ssalin/Practicum/README.md

# Practicum

adding the following libraries for eagle:

https://github.com/sparkfun/SparkFun-Eagle-Libraries
https://github.com/adafruit/Adafruit-Eagle-Library
