ssalin/Practicum/Documentation/Project Planning/BluDAQ Project Schedule (V1.0).png

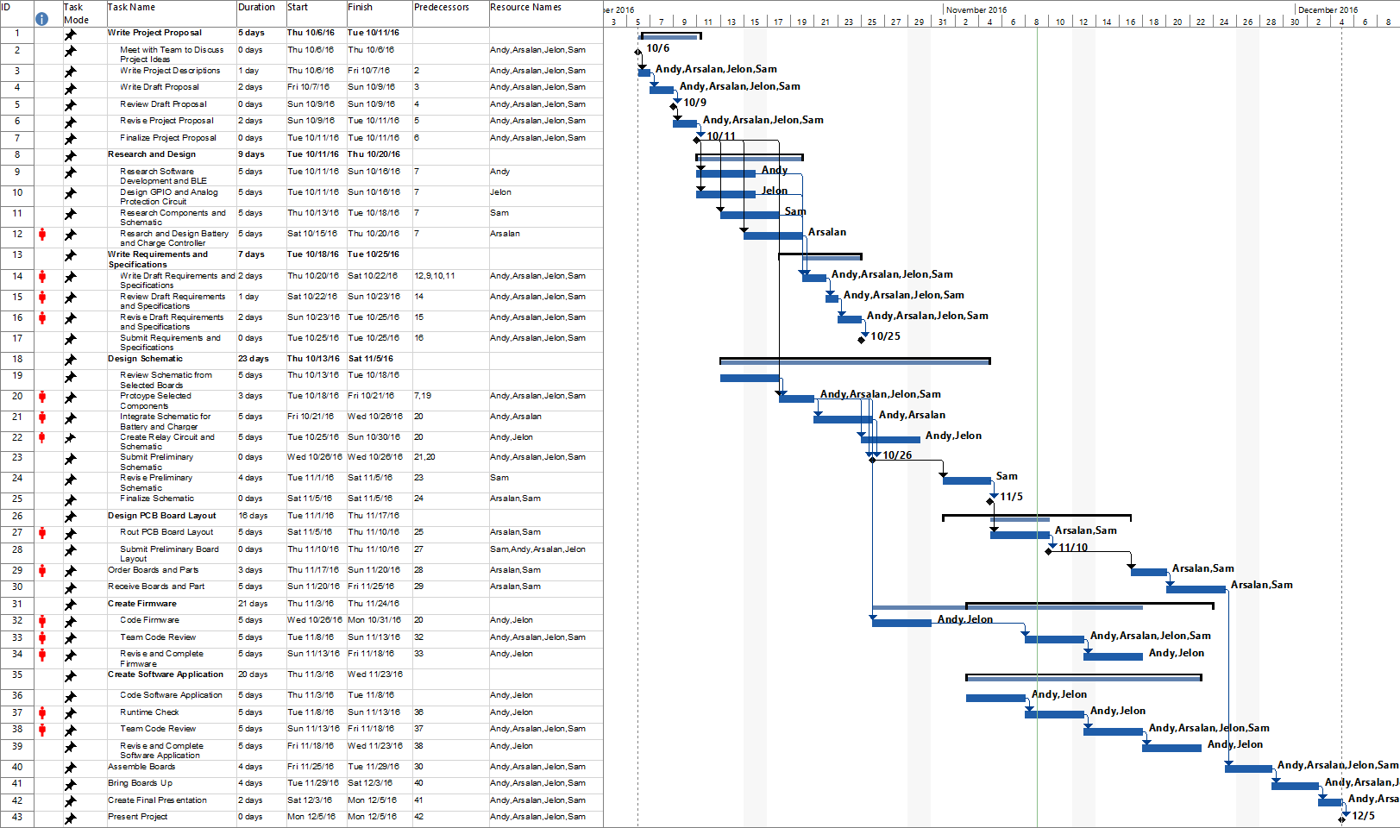
Documentation/Project Planning/BluDAQ Project Schedule (V1.0).png
