ssalin/Practicum/Hardware/refrence_schematics/ATMega8 Schm.jpg

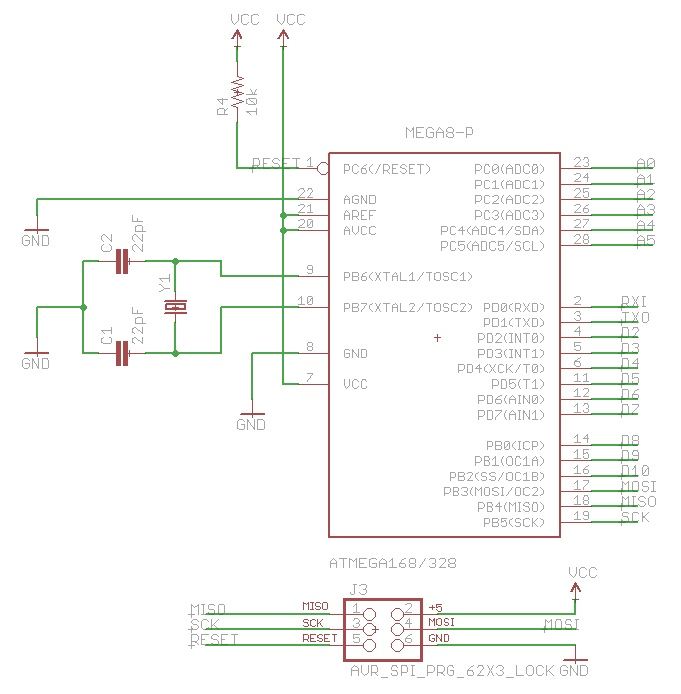
Hardware/refrence_schematics/ATMega8 Schm.jpg
