ssalin/Practicum/Hardware/schematics/Layout Proposal.png

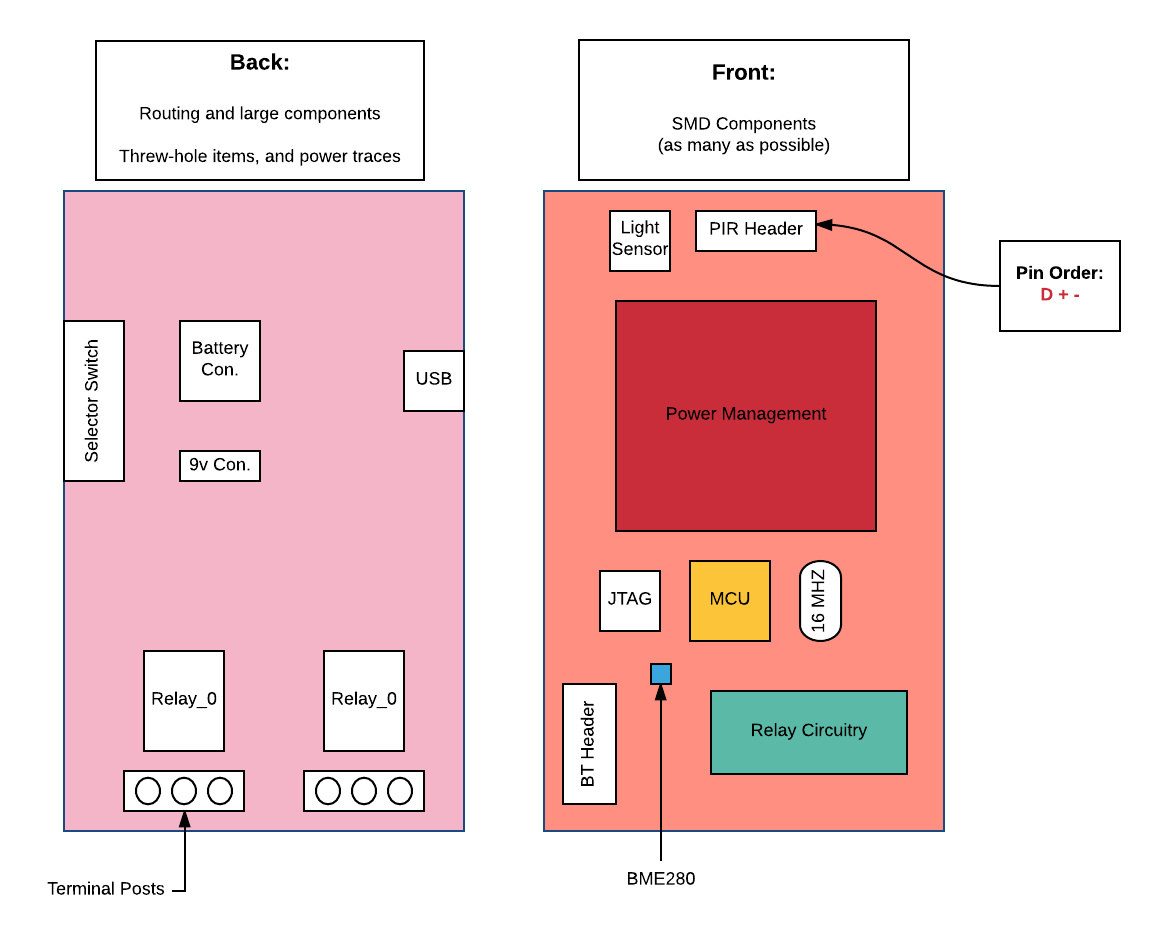
Hardware/schematics/Layout Proposal.png
