ssalin/Practicum/Hardware/schematics/layout_Nov_16.png

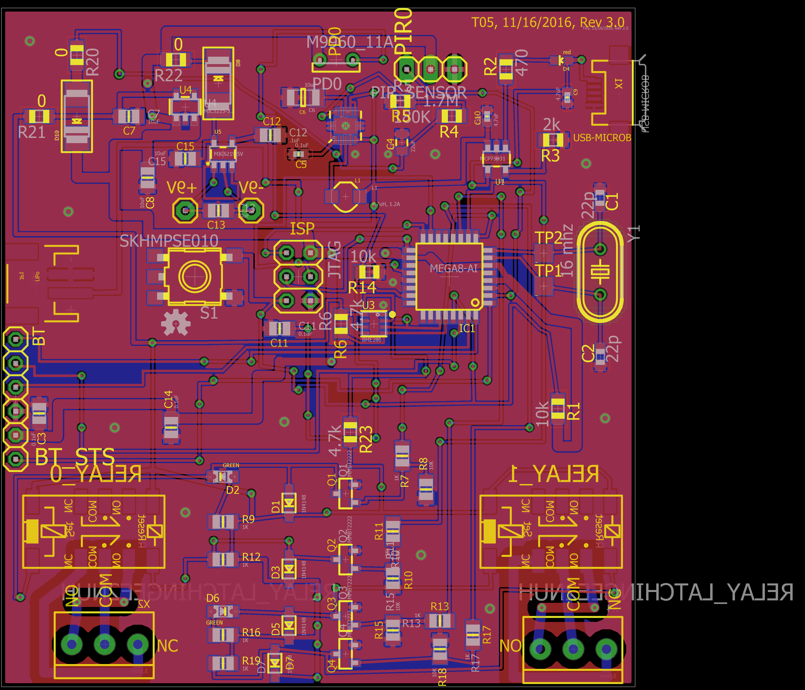
Hardware/schematics/layout_Nov_16.png
