ssalin/Practicum/Hardware/schematics/schematic_Nov_16.png

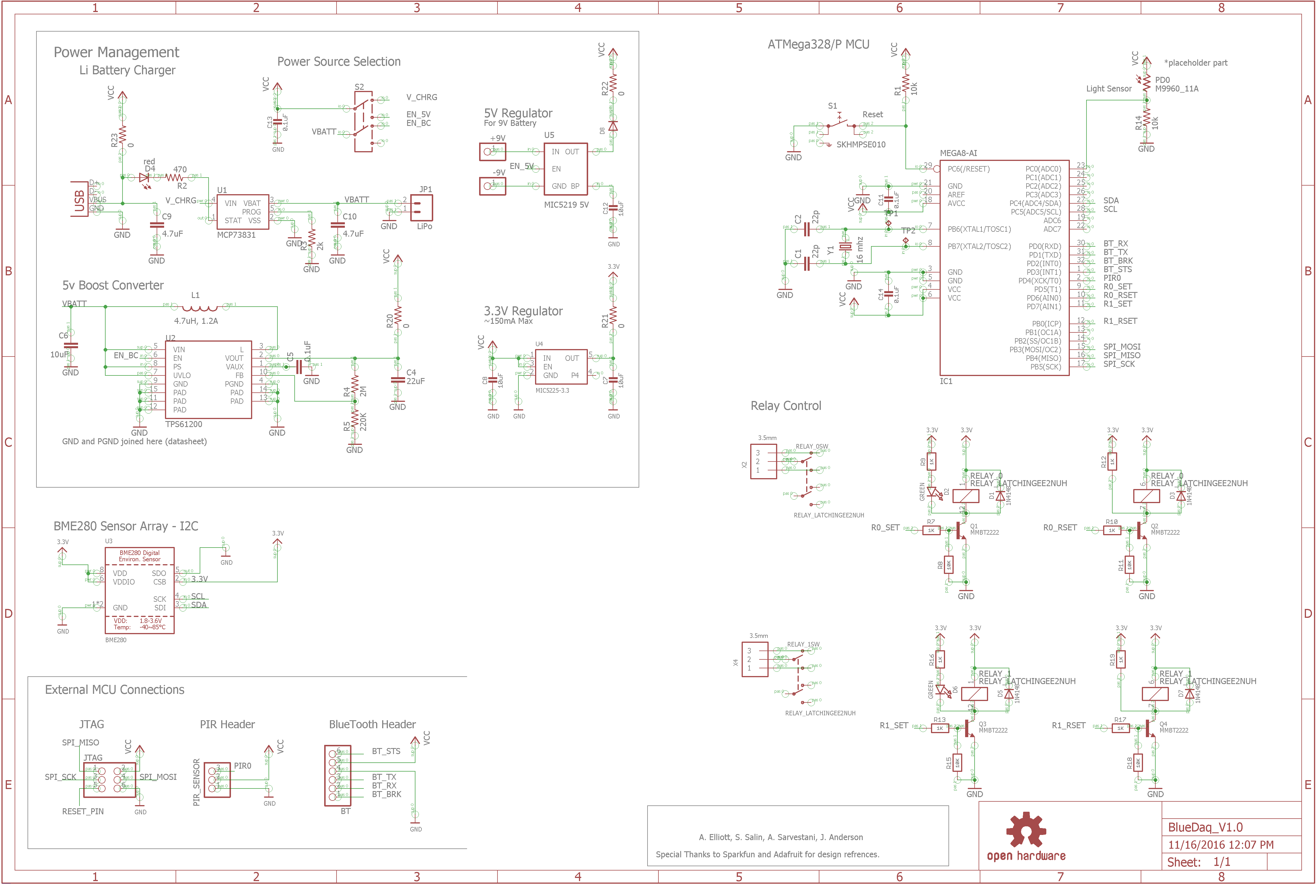
Hardware/schematics/schematic_Nov_16.png
