ssalin/Practicum/Hardware/Docs/Parts_list.xlsx

Part | Value | Numer Needed Per board | Package | Price Per Unit | Cost per board | # boards | Total Cost
PIR sensor |  | 1 |  | 9.95 | 9.95 |  | 39.8
Bluetooth Adaptor |  | 1 |  |  | 0 |  | 0
Capactior | 22p | 2 | C0805 | 0.1 | 0.2 |  | 0.8
Capactior | 0.1uF | 5 | 0805-NO@1 | 0.1 | 0.5 |  | 2
Capactior | 22uF | 1 | 805 | 0.23 | 0.23 |  | 0.92
Capactior | 10uF | 1 | 1206 | 0.22 | 0.22 |  | 0.88
Capactior | 10uF | 4 | 805 | 0.13 | 0.52 |  | 2.08
Capactior | 4.7uF | 2 | 805 | 0.15 | 0.3 |  | 1.2
Resistor | 10k | 6 | R0805 | 0.1 | 0.6 |  | 2.4
Resistor | 470 | 1 | R0805 | 0.1 | 0.1 |  | 0.4
Resistor | 2k | 1 | R0805 | 0.1 | 0.1 |  | 0.4
Resistor | 1.7M | 1 | R0805 | 0.1 | 0.1 |  | 0.4
Resistor | 180k | 1 | R0805 | 0.1 | 0.1 |  | 0.4
Resistor | 4.7k | 2 | R0805 | 0.1 | 0.2 |  | 0.8
Resistor | 1k | 8 | R0805 | 0.1 | 0.8 |  | 3.2
Resistor | 0 | 3 | R0805 | 0.1 | 0.3 |  | 1.2
Diode | 1N4148 | 4 |  | 0.14 | 0.56 |  | 2.24
Diode | Green | 3 | 805 |  | 0 |  | 0
Diode |  | 2 | SMADIODE |  | 0 |  | 0
Processor | Atmega 328p | 1 | TQFP32-08 | 3.81 | 3.81 |  | 15.24
LiPo Connector |  | 1 | JST-2-SMD |  | 0 |  | 0
L1 4.7uH, 1.2A |  |  | CDRH2D09 |  | 0 |  | 0
PD0 | M9960_11A |  | M9960 |  | 0 |  | 0
NPN Transistor | MMBT2222 | 4 | SOT23-R | 0.1 | 0.4 |  | 1.6
RELAY | 2 |  |  |  | 0 |  | 0
S1 | SKHMPSE010 | 1 | SKHMPXE010 |  | 0 |  | 0
Test Pad |  | 2 | TP19SQ |  | 0 |  | 0
Battery Charger | MCP73831 | 1 | SOT23-5 | 0.56 | 0.56 |  | 2.24
Boost Converter | TPS61200 | 1 | QFN-10_PAD |  | 0 |  | 0
Temp/Humidity/Pressure sensor | BME280 | 1 | BME280 |  | 0 |  | 0
3.3v linear regulator | MIC5225-3.3 | 1 | SOT23-5 | 0.39 | 0.39 |  | 1.56
5v linear regulator | MIC5219 5V | 1 | SOT23-5 |  | 0 |  | 0
Micro USB adaptor | USB-MICROB | 1 | USB-MICROB | 0.46 | 0.46 |  | 1.84
X2 3.5mm | 2 | 2 | TERMBLOCK_1X3-3.5MM |  | 0 |  | 0
Y1 | 16 mhz | 1 | HC49U-V |  | 0 |  | 0
