ssalin/Practicum/Documentation/Team Docs/Practicum Cost Sheet.xlsx

Date | Purchase | Justification / Reason | Name of Purchaser | Retailer | Total Cost
2016-10-06 | Serial Bluetooth Device | Prototyping | Andy Elliott | PSU LID | $25.00
2016-10-06 | SPI BLE Devic, Environment Sensors, Photocell | Prototyping / Development | Andy Elliott | Adafruit | $48.05
2016-10-15 | 10x 5v SPST Relays | Prototype and Final | Andy Elliott | Amazon | $8.00
