ssalin/Practicum/Documentation/Project Planning/Idea Evaluation Matrix.xlsx

Idea | Est. Cost | Difficulty / Assembly | Astestics | Functionality | Practicality / Usefullness | Score
Automated Streetlight | 2 | 3 | 1 | 3.5 | 4 | 13.5
BLE DAS + FHT | 2 | 0 | 3 | 5 | 4 | 14
Programmable Game IF | 4 | 4 | 4 | 1 | 1 | 14
IR Blaster Remote | 4 | 3 | 3 | 2 | 3 | 15
Laser RC Car | 2 | 1 | 4 | 1 | 1 | 9
USB MIDI LED Driver | 3 | 3 | 1 | 2 | 2 | 11
EEG / EKG / EMG Control System |  |  |  |  |  | 0
Laser Shotgun | 0 | 0 | 4 | 0 | 0 | 4
