ssalin/Practicum/Firmware/BluDaq Firmware.pdf

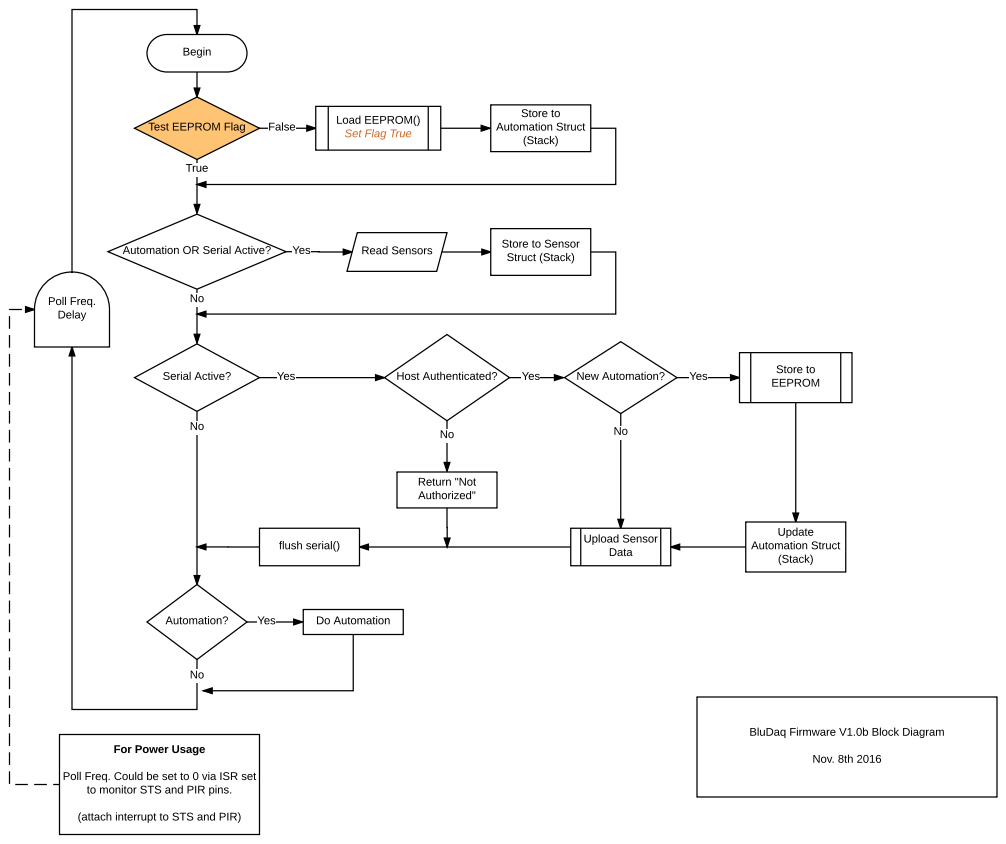
[picture p27: page 1]
Begin; Serial Active?; flush serial(); New Automation?; Nov. 8th 2016; Update Automation Struct (Stack); Automation?; Yes; Do Automation; Store to EEPROM; Read Sensors; False; True; Store to Automation Struct (Stack); Host Authenticated?; Return "Not Authorized"

Load EEPROM()
Set Flag True

Test EEPROM Flag

Automation OR Serial Active?

Store to Sensor
Struct (Stack)

Poll Freq. Delay

Upload Sensor Data

BluDaq Firmware V1.0b Block Diagram

For Power Usage

Poll Freq. Could be set to 0 via ISR set
to monitor STS and PIR pins.

(attach interrupt to STS and PIR)
