ssalin/Practicum/Hardware/Sim/411 Schematic.asc

D1: diode
M1: nmos
M2: nmos
R1: res; 1k
R2: res; 10k
R3: res; 10k
R4: res; 1k
R5: res; 1k
V1: voltage; 5
V2: voltage; PULSE(0 1 0.25 1m 1m 0.25 0.5 5)
V3: voltage; PULSE(0 3.3 0.50 1m 1m 0.50 1 5)
Named nets: 0
.tran 0 2.5 0
These inputs are GPIO signals. Before entering, it must go through two Opto Isolators
