ssalin/Practicum/Hardware/schematics/BlueDaq_V1.0.brd

## EAGLE design Hardware/schematics/BlueDaq_V1.0.brd (2016-11-17)

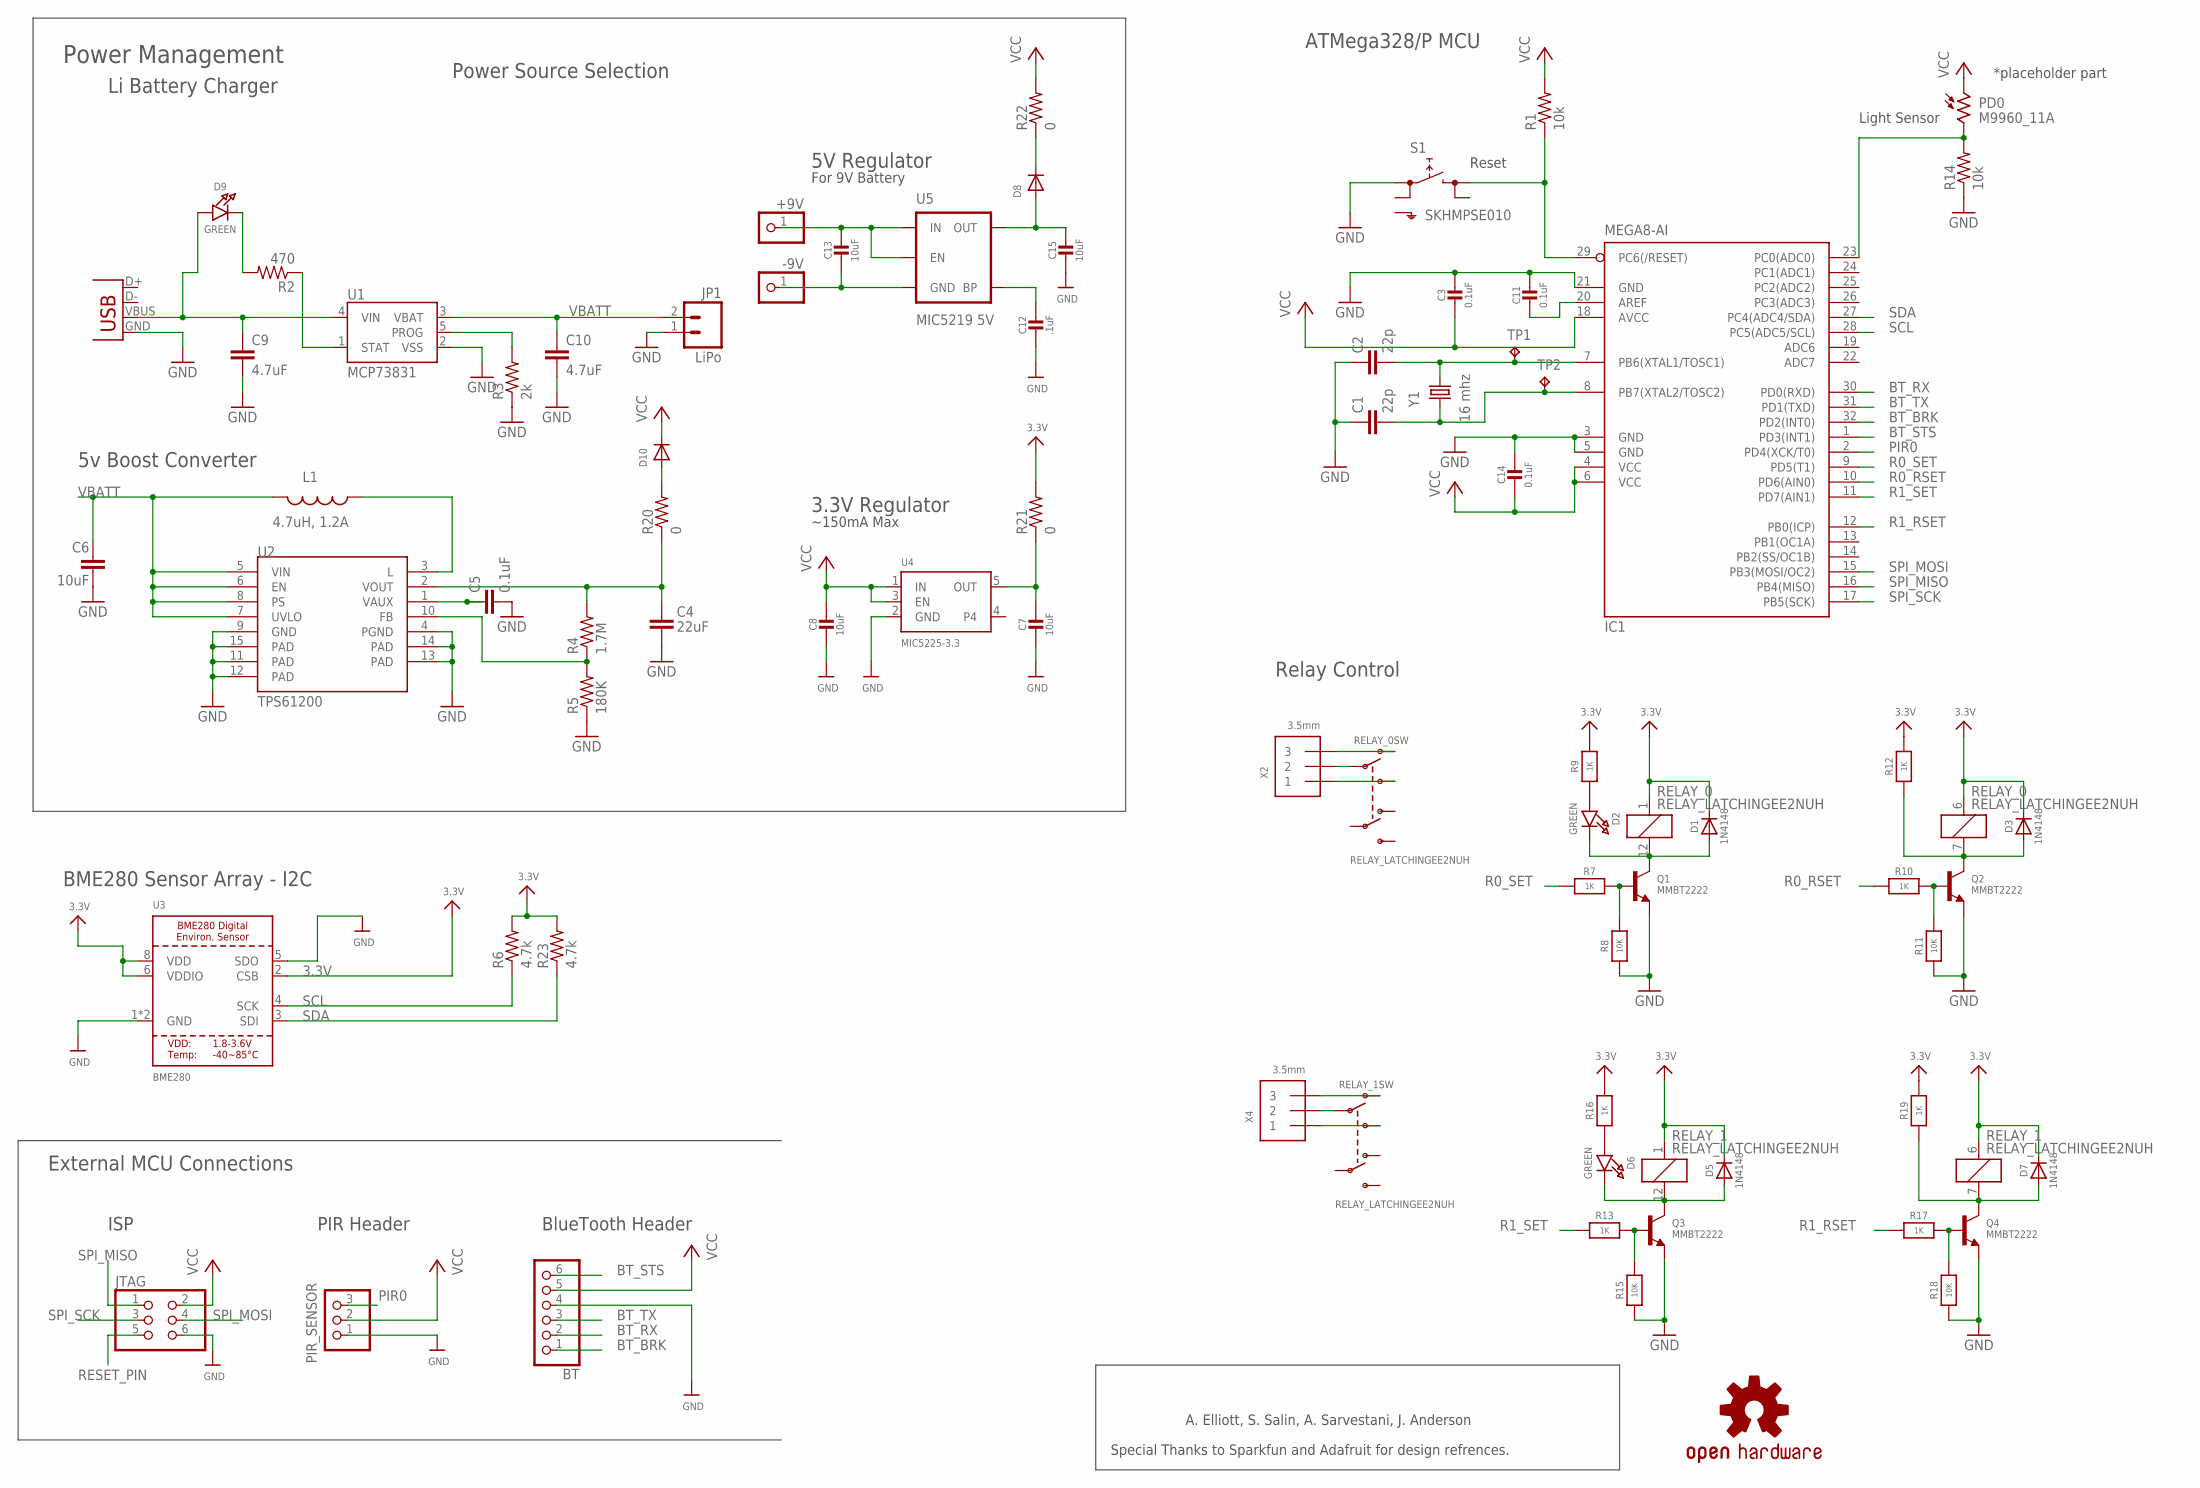
[picture p28: schematic BlueDaq_V1.0.sch]

Parts:
+9V: PINHD-1X1; 1X01
-9V: PINHD-1X1; 1X01
BT: PINHD-1X6; 1X06
C1, C2: 22p; C0805
C3, C11, C14: 0.1uF; 0805-NO@1
C4: 22uF; 0805
C5: 0.1uF; 0805
C6: 10uF; 1206
C7, C8, C13, C15: 10uF; 0805-NO@1
C9, C10: 4.7uF; 0805
C12: .1uF; 0805-NO@1
D1, D3, D5, D7: 1N4148; SOD-323
D2, D6, D9: GREEN; CHIPLED_0805_NOOUTLINE
D8, D10: DIODESMA; SMADIODE
IC1: MEGA8-AI; TQFP32-08
JP1: LiPo; JST-2-SMD
JTAG: PINHD-2X3; 2X03
L1: 4.7uH, 1.2A; CDRH2D09
PD0: M9960_11A; M9960
PIR_SENSOR: PINHD-1X3; 1X03
Q1, Q2, Q3, Q4: MMBT2222; SOT23-R
R1, R14: 10k; R0805
R2: 470; R0805
R3: 2k; R0805
R4: 1.7M; R0805
R5: 180K; R0805
R6, R23: 4.7k; R0805
R7, R9, R10, R12, R13, R16, R17, R19: 1K; 0805-NO
R8, R11, R15, R18: 10K; 0805-NO
R20, R21, R22: 0; R0805
RELAY_0, RELAY_1: RELAY_LATCHINGEE2NUH; RELAY_EE2_LATCH
S1: SKHMPSE010; SKHMPXE010
TP1, TP2: TPTP19SQ; TP19SQ
U1: MCP73831; SOT23-5
U2: TPS61200; QFN-10_PAD
U3: BME280
U4: MIC5225-3.3; SOT23-5
U5: MIC5219 5V; SOT23-5
U$22: OSHW-LOGOS; OSHW-LOGO-S
X1: USB-MICROB
X2, X4: 3.5mm; TERMBLOCK_1X3-3.5MM
Y1: 16 mhz; HC49U-V

Connections:
3.3V: D1.C, D3.C, D5.C, D7.C, R6.2, R9.2, R12.2, R16.2, R19.2, R21.2, R23.2, RELAY_0.1, RELAY_0.6 (1), RELAY_1.1, RELAY_1.6 (1), U3.2 (CSB), U3.6 (VDDIO), U3.8 (VDD)
BT_BRK: BT.1, IC1.32 (PD2(INT0))
BT_RX: BT.2, IC1.30 (PD0(RXD))
BT_STS: BT.6, IC1.1 (PD3(INT1))
BT_TX: BT.3, IC1.31 (PD1(TXD))
COM1: RELAY_0.9 (P1), X2.2
COM2: RELAY_1.9 (P1), X4.2
FB: R4.1, R5.2, U2.10 (FB)
GND: BT.4, C1.1, C2.1, C3.1, C4.2, C5.2, C6.2, C7.2, C8.2, C9.2, C10.2, C11.1, C12.2, C14.1, C15.2, IC1.3 (GND), IC1.5 (GND), IC1.21 (GND), JP1.1, JTAG.6, PIR_SENSOR.1, Q1.2 (E), Q2.2 (E), Q3.2 (E), Q4.2 (E), R3.1, R5.1, R8.1, R11.1, R14.1, R15.1, R18.1, S1.1 (1.1), U1.2 (VSS), U2.4 (PGND), U2.9 (GND), U2.11 (PAD), U2.12 (PAD), U2.13 (PAD), U2.14 (PAD), U2.15 (PAD), U3.1 (GND), U3.5 (SDO), U3.7 (GND), U4.2 (GND), X1.GND
unnamed: IC1.23 (PC0(ADC0)), PD0.2, R14.2
unnamed: L1.P$1 (1), U2.3 (L)
unnamed: C5.1, U2.1 (VAUX)
unnamed: D9.C, R2.2
unnamed: C15.1, D8.A, U5.5 (OUT)
unnamed: D1.A, D2.C, Q1.3 (C), RELAY_0.12 (2)
unnamed: D5.A, D6.C, Q3.3 (C), RELAY_1.12 (2)
unnamed: Q3.1 (B), R13.2, R15.2
unnamed: D6.A, R16.1
unnamed: RELAY_1.10 (O1), X4.3
unnamed: R3.2, U1.5 (PROG)
unnamed: D7.A, Q4.3 (C), R19.1, RELAY_1.7 (2)
unnamed: Q4.1 (B), R17.2, R18.2
unnamed: R2.1, U1.1 (STAT)
unnamed: +9V.1, C13.1, U5.1 (IN), U5.3 (EN)
unnamed: -9V.1, C13.2, U5.2 (GND)
unnamed: C12.1, U5.4 (BP)
unnamed: D8.C, R22.1
unnamed: D10.A, R20.2
unnamed: Q1.1 (B), R7.2, R8.2
unnamed: C9.1, D9.A, U1.4 (VIN), X1.VBUS
unnamed: D3.A, Q2.3 (C), R12.1, RELAY_0.7 (2)
unnamed: D2.A, R9.1
unnamed: Q2.1 (B), R10.2, R11.2
unnamed: RELAY_0.10 (O1), X2.3
unnamed: C11.2, IC1.20 (AREF)
NO1: RELAY_0.8 (S1), X2.1
NO2: RELAY_1.8 (S1), X4.1
OUT: C7.1, R21.1, U4.5 (OUT)
PIR0: IC1.2 (PD4(XCK/T0)), PIR_SENSOR.3
R0_RSET: IC1.10 (PD6(AIN0)), R10.1
R0_SET: IC1.9 (PD5(T1)), R7.1
R1_RSET: IC1.12 (PB0(ICP)), R17.1
R1_SET: IC1.11 (PD7(AIN1)), R13.1
RESET_PIN: IC1.29 (PC6(/RESET)), JTAG.5, R1.1, S1.3 (2.1)
SCL: IC1.28 (PC5(ADC5/SCL)), R6.1, U3.4 (SCK)
SDA: IC1.27 (PC4(ADC4/SDA)), R23.1, U3.3 (SDI)
SPI_MISO: IC1.16 (PB4(MISO)), JTAG.1
SPI_MOSI: IC1.15 (PB3(MOSI/OC2)), JTAG.4
SPI_SCK: IC1.17 (PB5(SCK)), JTAG.3
VBATT: C6.1, C10.1, JP1.2, L1.P$2 (2), U1.3 (VBAT), U2.5 (VIN), U2.6 (EN), U2.7 (UVLO), U2.8 (PS)
VCC: BT.5, C3.2, C8.1, C14.2, D10.C, IC1.4 (VCC), IC1.6 (VCC), IC1.18 (AVCC), JTAG.2, PD0.1, PIR_SENSOR.2, R1.2, R22.2, U4.1 (IN), U4.3 (EN)
VOUT: C4.1, R4.2, R20.1, U2.2 (VOUT)
XTAL1: C2.2, IC1.7 (PB6(XTAL1/TOSC1)), TP1.TP, Y1.2
XTAL2: C1.2, IC1.8 (PB7(XTAL2/TOSC2)), TP2.TP, Y1.1

Notes on the sheet:
Li Battery Charger
5v Boost Converter
ATMega328/P MCU
Reset
External MCU Connections
BME280 Sensor Array - I2C
~150mA Max
3.3V Regulator
ISP
PIR Header
BlueTooth Header
Light Sensor
*placeholder part
Relay Control
5V Regulator
For 9V Battery
Power Source Selection
Power Management
A. Elliott, S. Salin, A. Sarvestani, J. Anderson
Special Thanks to Sparkfun and Adafruit for design refrences.

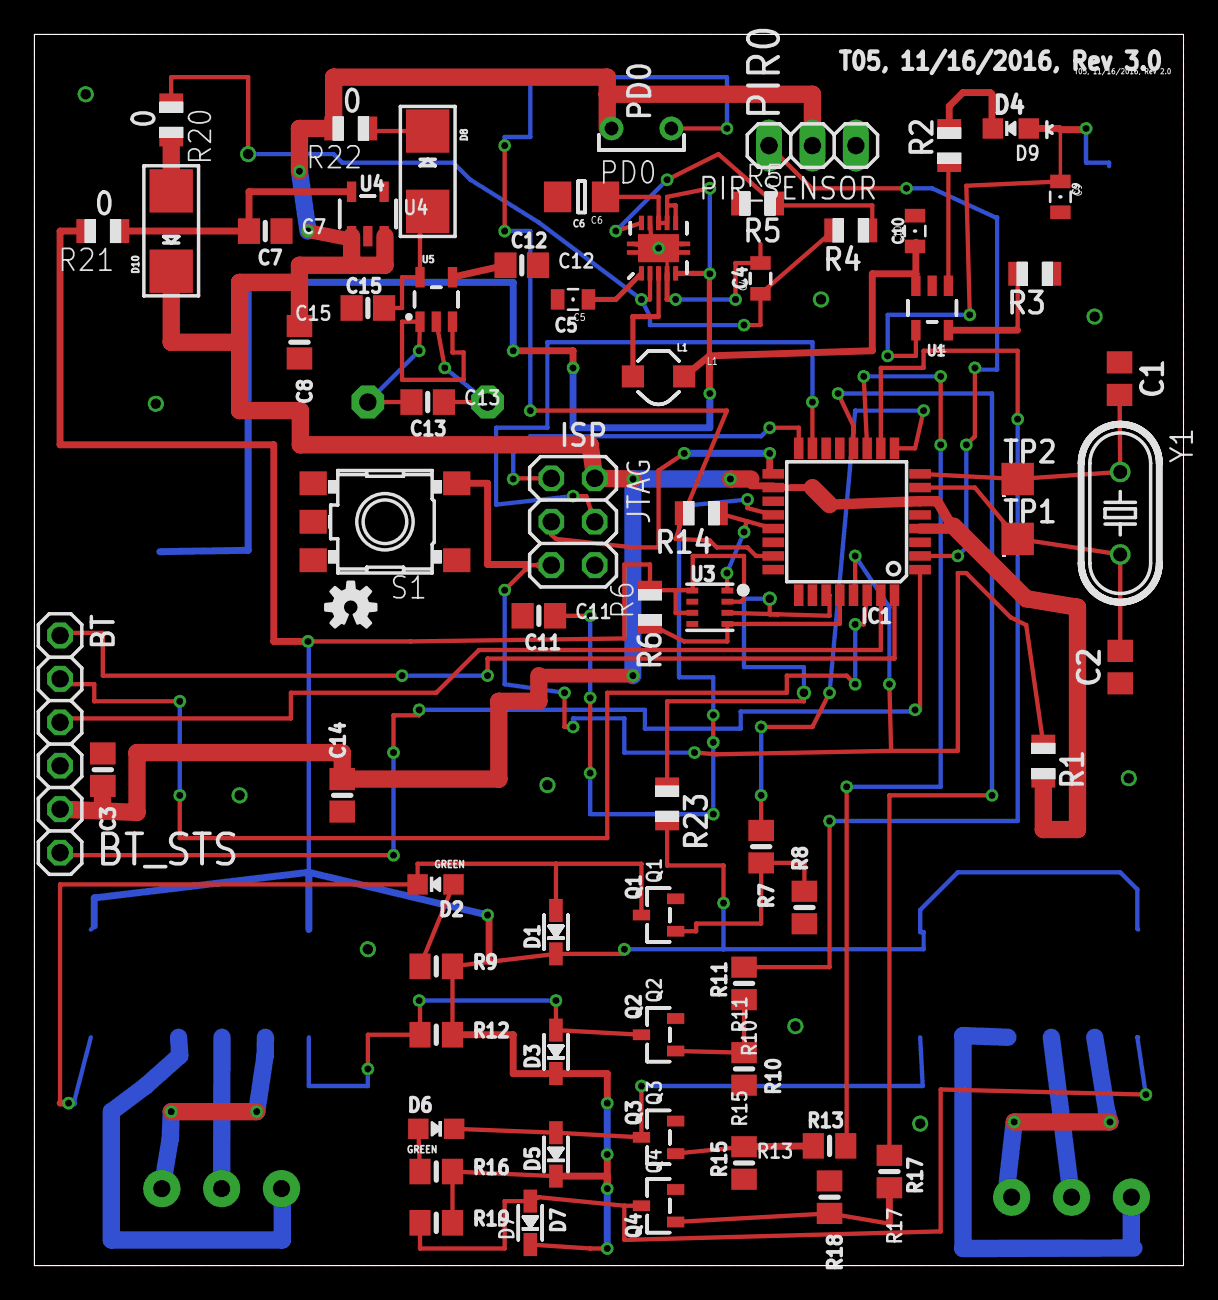
[picture p29: board BlueDaq_V1.0.brd from above]

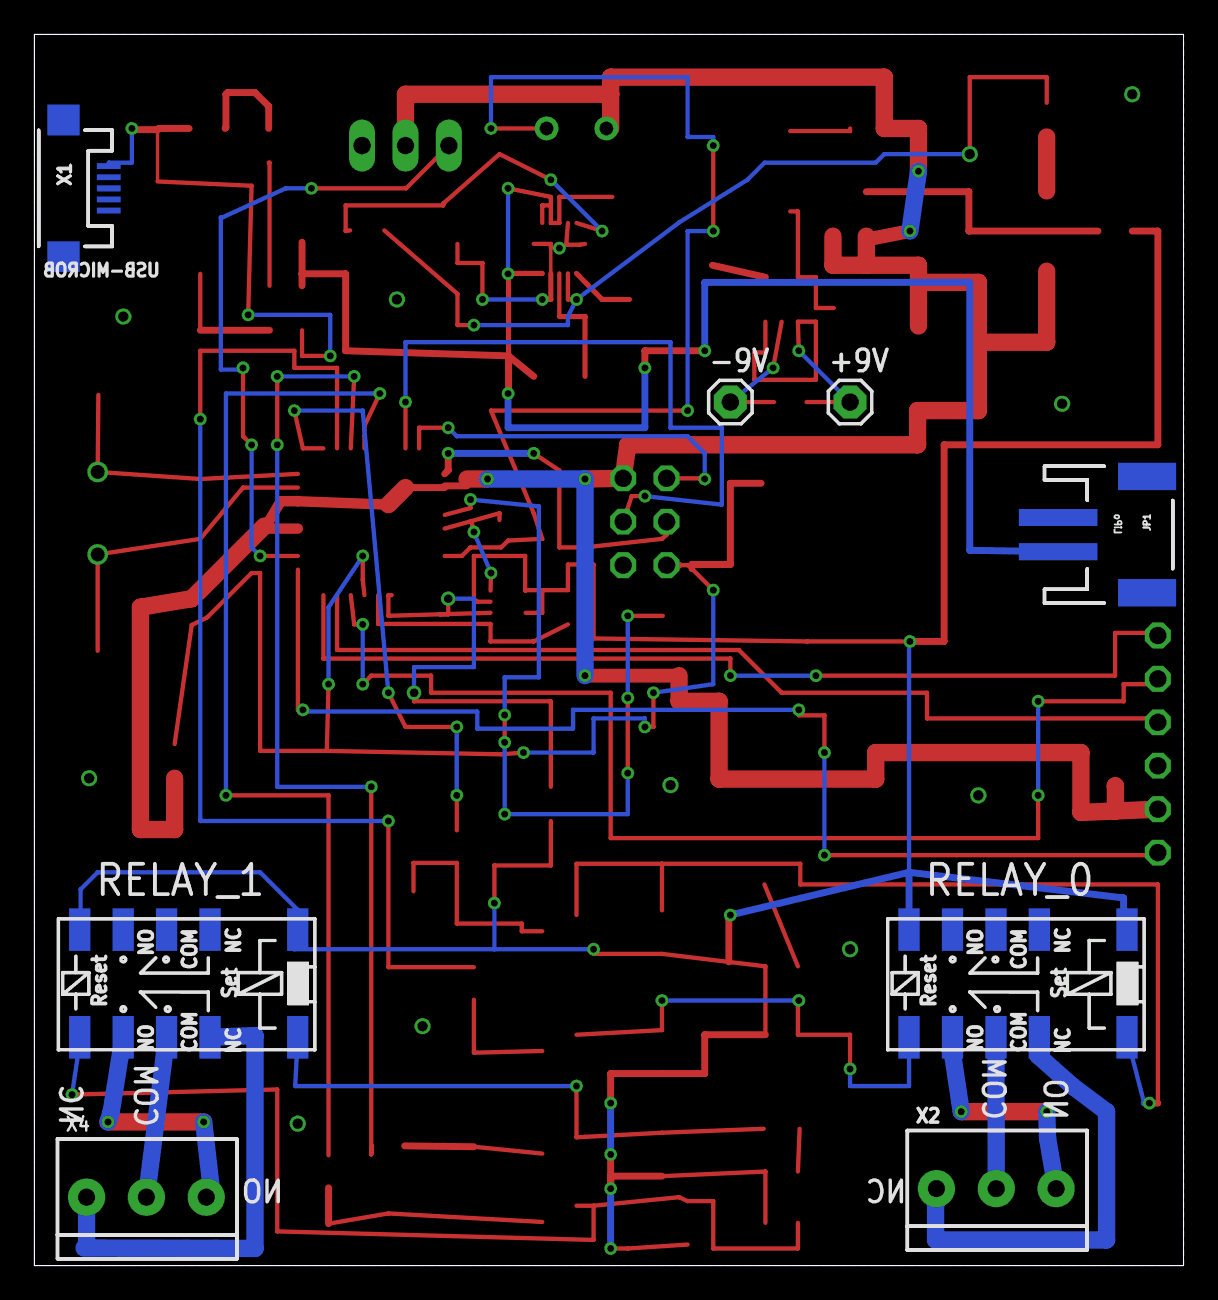
[picture p30: board BlueDaq_V1.0.brd from below]

Board: 2 copper layers, 67.2 x 72.0 mm, 75 parts (8 on the bottom side), 54 nets.
