ssalin/Practicum/Hardware/refrence_schematics/adafruit/Adafruit Relay FeatherWing.brd

## EAGLE design Hardware/refrence_schematics/adafruit/Adafruit Relay FeatherWing.brd (2016-11-03)

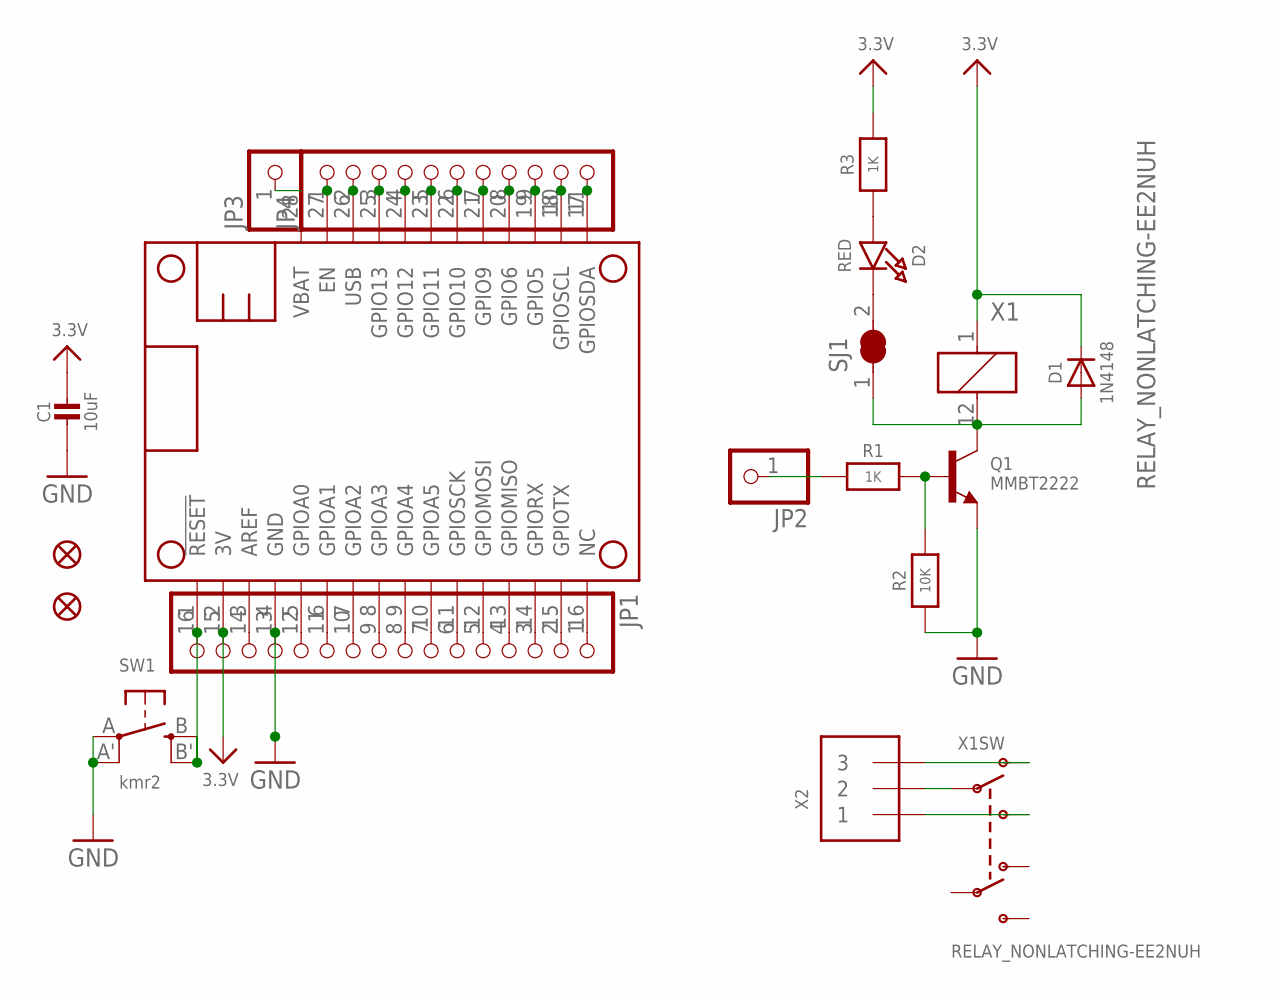
[picture p31: schematic Adafruit Relay FeatherWing.sch]

Parts:
C1: 10uF; 0805-NO
D1: 1N4148; SOD-323
D2: RED; CHIPLED_0805_NOOUTLINE
FID2, FID3: FIDUCIAL""; FIDUCIAL_1MM
JP1: HEADER-1X16ROUND; 1X16_ROUND
JP2, JP3: HEADER-1X1ROUND; 1X01_ROUND
JP4: HEADER-1X11; 1X11_ROUND
MS1: MICROSHIELD
Q1: MMBT2222; SOT23-R
R1, R3: 1K; 0805-NO
R2: 10K; 0805-NO
SJ1: SOLDERJUMPER_CLOSED; SOLDERJUMPER_CLOSEDWIRE
SW1: kmr2; BTN_KMR2_4.6X2.8
X1: RELAY_NONLATCHING-EE2NUH; RELAY_EE2_NOLATCH
X2: TERMBLOCK_1X3; TERMBLOCK_1X3-3.5MM

Connections:
3.3V: C1.1, D1.C, JP1.15, MS1.2 (3V), R3.2, X1.1
COM1: X1.9 (P1), X2.2
GND: C1.2, JP1.13, MS1.4 (GND), Q1.2 (E), R2.1, SW1.A, SW1.A' (P1)
unnamed: D1.A, Q1.3 (C), SJ1.1, X1.12 (2)
unnamed: JP1.1, MS1.16 (NC)
unnamed: JP1.2, MS1.15 (GPIOTX)
unnamed: JP1.3, MS1.14 (GPIORX)
unnamed: JP1.4, MS1.13 (GPIOMISO)
unnamed: JP1.5, MS1.12 (GPIOMOSI)
unnamed: JP1.6, MS1.11 (GPIOSCK)
unnamed: JP1.7, MS1.10 (GPIOA5)
unnamed: JP1.8, MS1.9 (GPIOA4)
unnamed: JP1.9, MS1.8 (GPIOA3)
unnamed: JP1.10, MS1.7 (GPIOA2)
unnamed: JP1.11, MS1.6 (GPIOA1)
unnamed: JP1.12, MS1.5 (GPIOA0)
unnamed: JP4.1, MS1.27 (EN)
unnamed: JP4.3, MS1.25 (GPIO13)
unnamed: JP4.4, MS1.24 (GPIO12)
unnamed: JP4.5, MS1.23 (GPIO11)
unnamed: JP4.6, MS1.22 (GPIO10)
unnamed: JP4.7, MS1.21 (GPIO9)
unnamed: JP4.8, MS1.20 (GPIO6)
unnamed: JP4.9, MS1.19 (GPIO5)
unnamed: Q1.1 (B), R1.2, R2.2
unnamed: JP1.14, MS1.3 (AREF)
unnamed: JP2.1, R1.1
unnamed: D2.C, SJ1.2
unnamed: D2.A, R3.1
unnamed: X1.10 (O1), X2.3
NO1: X1.8 (S1), X2.1
RESET: JP1.16, MS1.1 (!RESET), SW1.B (S), SW1.B' (S1)
SCL: JP4.10, MS1.18 (GPIOSCL)
SDA: JP4.11, MS1.17 (GPIOSDA)
USB: JP4.2, MS1.26 (USB)
VBAT: JP3.1, MS1.28 (VBAT)

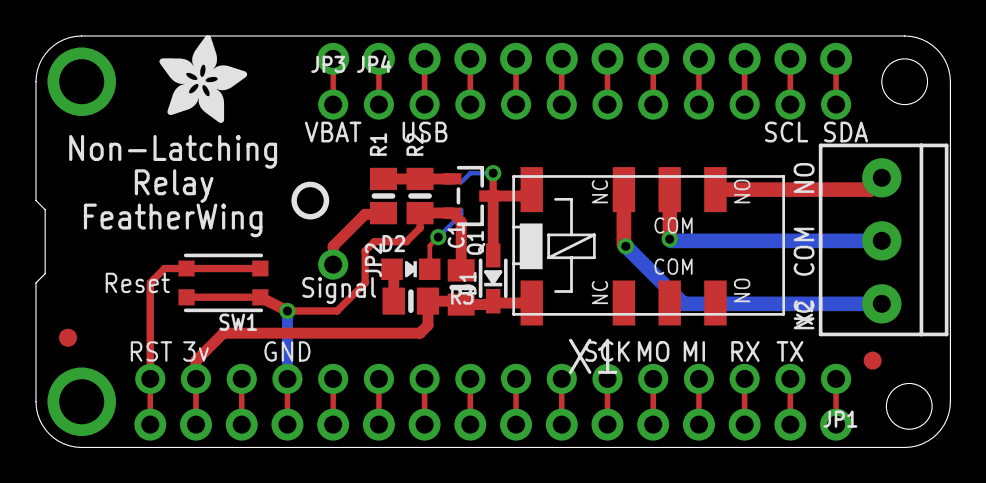
[picture p32: board Adafruit Relay FeatherWing.brd from above]

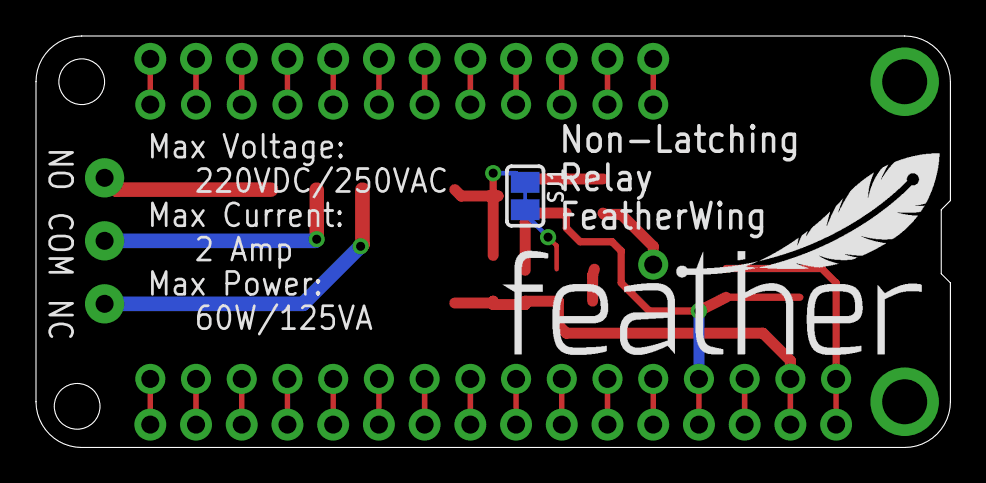
[picture p33: board Adafruit Relay FeatherWing.brd from below]

Board: 2 copper layers, 50.8 x 22.9 mm, 21 parts (2 on the bottom side), 36 nets.

Other parts of the board:
U$5: PCBFEAT-REV-040
U$6: FEATHERLOGO
U$7: ADAFRUIT_5MM
