ssalin/Practicum/Hardware/refrence_schematics/adafruit/Adafruit EZ-Link Breakout.brd

## EAGLE design Hardware/refrence_schematics/adafruit/Adafruit EZ-Link Breakout.brd (2016-11-03)

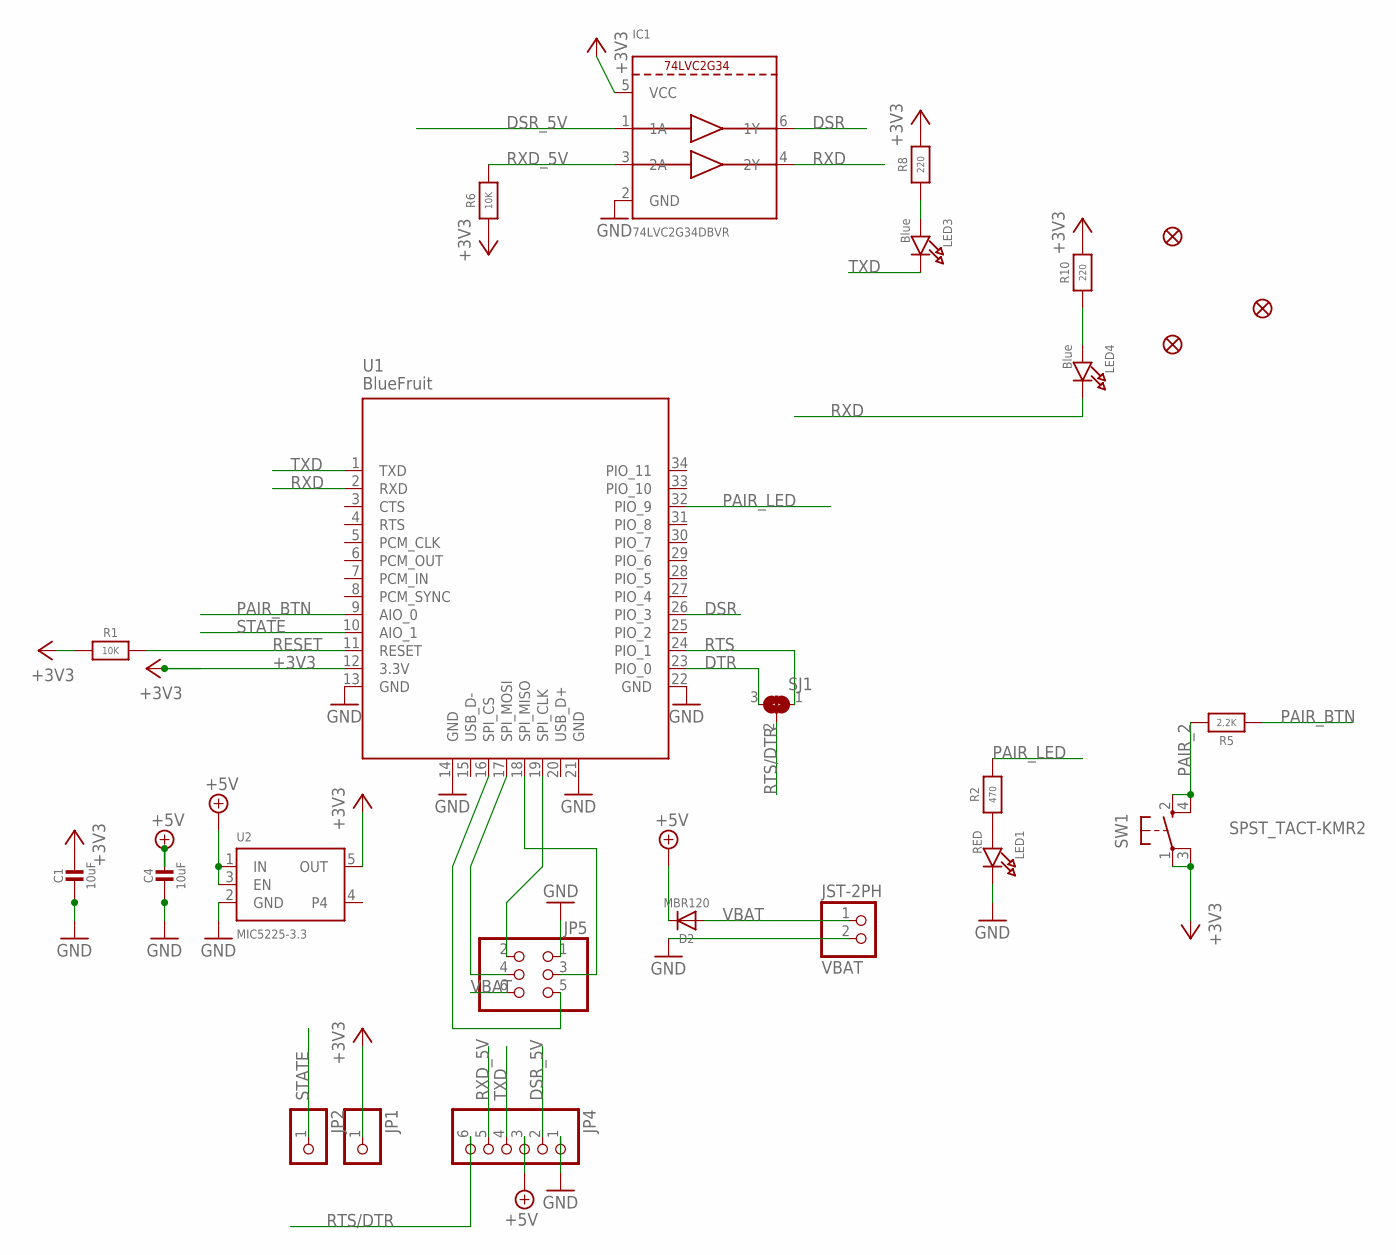
[picture p34: schematic Adafruit EZ-Link Breakout.sch]

Parts:
C1, C4: 10uF; 0805-NO
D2: MBR120; SOD-123
FID1, FID2, FID3: FIDUCIAL""; FIDUCIAL_1MM
IC1: 74LVC2G34DBVR; SOT23-6
JP1, JP2: PINHD-1X1CB; 1X01-CLEANBIG
JP4: PINHD-1X6B; 1X06-BIG
JP5: HEADER-2X3; 2X03_ROUND_70MIL
LED1: RED; CHIPLED_0805_NOOUTLINE
LED3, LED4: Blue; CHIPLED_0805_NOOUTLINE
R1: 10K; 0805-NO
R2: 470; 0805-NO
R5: 2.2K; 0805-NO
R6: 10K; _0805MP
R8, R10: 220; 0805-NO
SJ1: SOLDERJUMPER_2WAY; SOLDERJUMPER_2WAY_OPEN_NOPASTE
SW1: SPST_TACT-KMR2; KMR2
U1: BlueFruit; BLUETOOTH_MODULE
U2: MIC5225-3.3; SOT23-5
VBAT: JST-2PH; JST-PH-2-SMT-RA

Connections:
+3V3: C1.1, IC1.5 (VCC), JP1.1, R1.1, R6.1, R8.2, R10.2, SW1.1, SW1.3 (P1), U1.12 (3.3V), U2.5 (OUT)
+5V: C4.1, D2.C, JP4.3, U2.1 (IN), U2.3 (EN)
DSR: IC1.6 (1Y), U1.26 (PIO_3)
DSR_5V: IC1.1 (1A), JP4.2
DTR: SJ1.3, U1.23 (PIO_0)
GND: C1.2, C4.2, IC1.2 (GND), JP4.1, JP5.1, LED1.C, U1.13 (GND), U1.14 (GND), U1.21 (GND), U1.22 (GND), U2.2 (GND), VBAT.2 (1)
unnamed: LED1.A, R2.1
unnamed: LED3.A, R8.1
unnamed: LED4.A, R10.1
PAIR_2: R5.2, SW1.2 (S), SW1.4 (S1)
PAIR_BTN: R5.1, U1.9 (AIO_0)
PAIR_LED: R2.2, U1.32 (PIO_9)
RESET: R1.2, U1.11 (RESET)
RTS: SJ1.1, U1.24 (PIO_1)
RTS/DTR: JP4.6, SJ1.2
RXD: IC1.4 (2Y), LED4.C, U1.2 (RXD)
RXD_5V: IC1.3 (2A), JP4.5, R6.2
SPI_CLK: JP5.2, U1.19 (SPI_CLK)
SPI_CS: JP5.5, U1.16 (SPI_CS)
SPI_MISO: JP5.3, U1.18 (SPI_MISO)
SPI_MOSI: JP5.4, U1.17 (SPI_MOSI)
STATE: JP2.1, U1.10 (AIO_1)
TXD: JP4.4, LED3.C, U1.1 (TXD)
VBAT: D2.A, JP5.6, VBAT.1 (2)

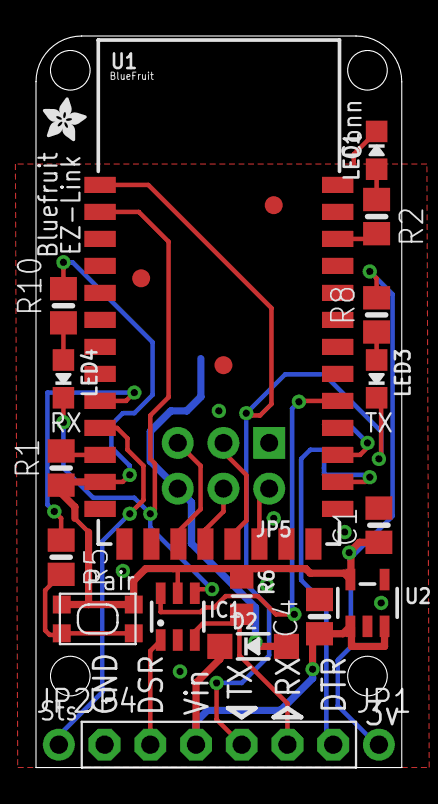
[picture p35: board Adafruit EZ-Link Breakout.brd from above]

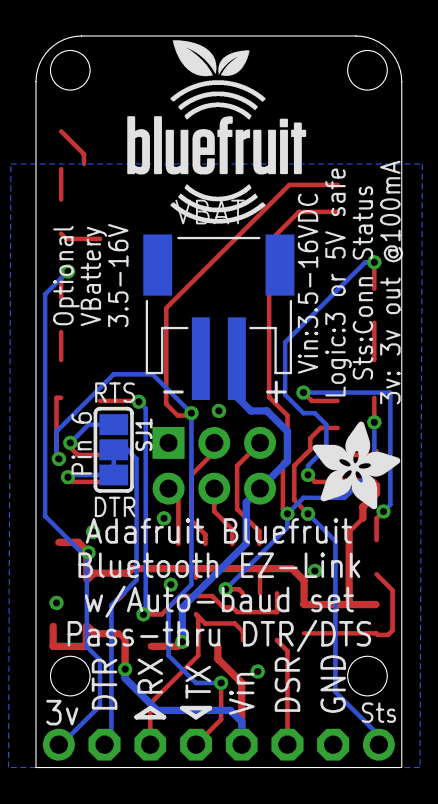
[picture p36: board Adafruit EZ-Link Breakout.brd from below]

Board: 2 copper layers, 20.3 x 40.6 mm, 28 parts (4 on the bottom side), 24 nets.

Other parts of the board:
U$2: ADAFRUIT_5MM
U$3: ADAFRUIT_2.5MM
U$4: BLUEFRUITLOGO_100MM
