ssalin/Practicum/Hardware/refrence_schematics/sparkfun/PowerCell-v13.brd

## EAGLE design Hardware/refrence_schematics/sparkfun/PowerCell-v13.brd (2016-11-03)

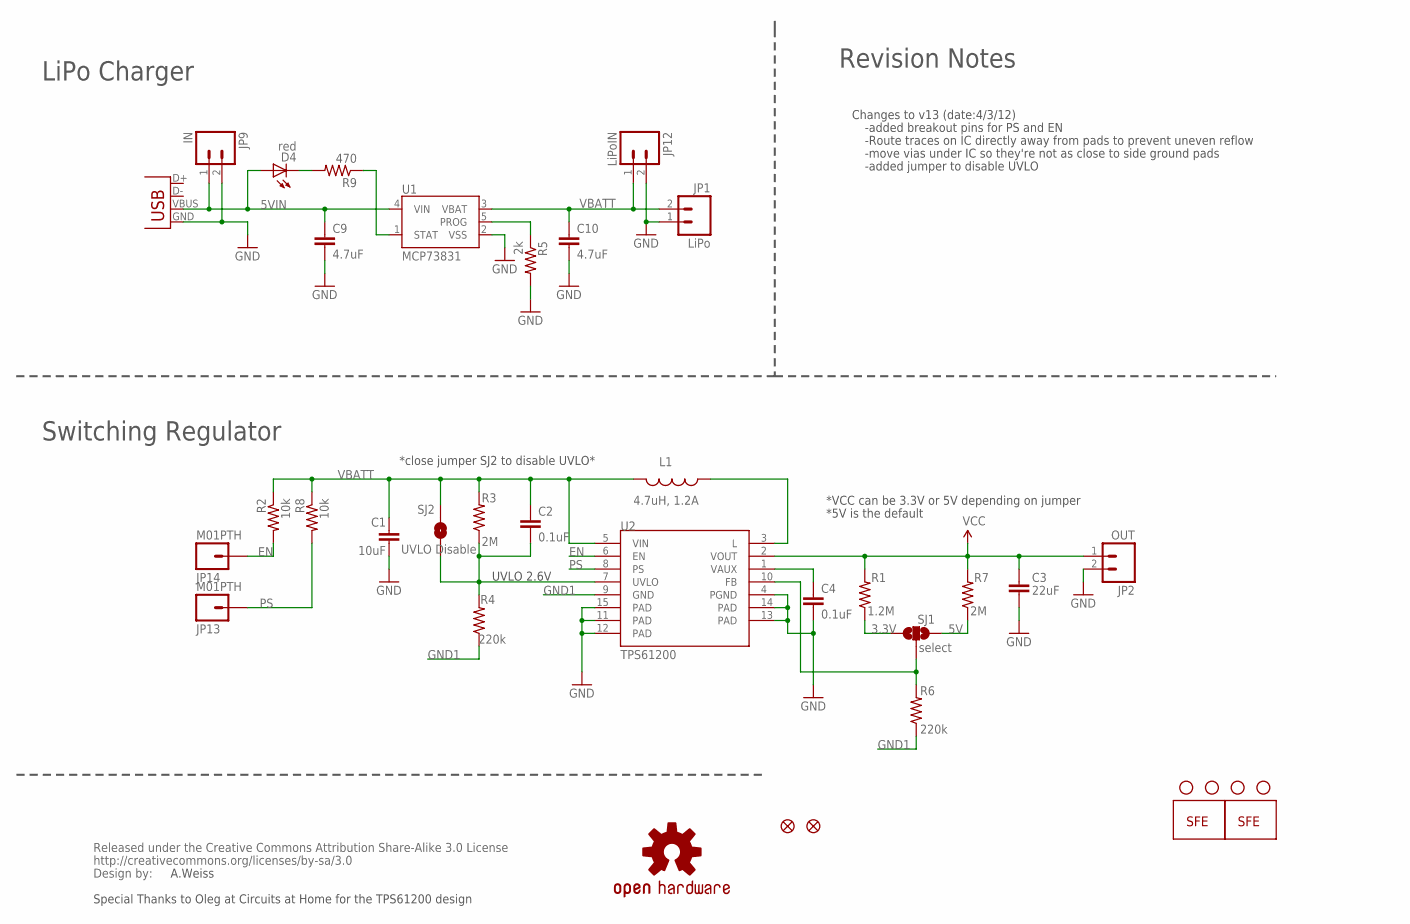
[picture p43: schematic PowerCell-v13.sch]

Parts:
C1: 10uF; 1206
C2, C4: 0.1uF; 0402-CAP
C3: 22uF; 0805
C9, C10: 4.7uF; 0402-CAP
D4: red; LED-0603
JP1: LiPo; JST-2-SMD
JP2: OUT; 1X02
JP3: LOGO-SFENEW; SFE-NEW-WEBLOGO
JP4: LOGO-SFESK; SFE-LOGO-FLAME
JP5, JP6, JP7, JP8: STAND-OFF
JP9: IN; 1X02
JP12: LiPoIN; 1X02
JP13, JP14: M01PTH; 1X01
JP15, JP16: FIDUCIALUFIDUCIAL; MICRO-FIDUCIAL
L1: 4.7uH, 1.2A; CDRH2D09
R1: 1.2M; 0402-RES
R2, R8: 10k; 0402-RES
R3, R7: 2M; 0402-RES
R4, R6: 220k; 0402-RES
R5: 2k; 0402-RES
R9: 470; 0402-RES
SJ1: select; SJ_3_PASTE2&3
SJ2: UVLO Disable; SJ_2S-NO
U1: MCP73831; SOT23-5
U2: TPS61200; QFN-10_PAD
U$1: OSHW-LOGOS; OSHW-LOGO-S
U$2: CREATIVE_COMMONS
X1: USB-MICROB

Connections:
3.3V: R1.1, SJ1.1
5V: R7.1, SJ1.3
5VIN: C9.1, D4.A, JP9.1, U1.4 (VIN), X1.VBUS
EN: JP14.1, R2.2, U2.6 (EN)
FB: R6.2, SJ1.2, U2.10 (FB)
GND: C1.2, C3.2, C4.2, C9.2, C10.2, JP1.1, JP2.2, JP9.2, JP12.2, R5.2, U1.2 (VSS), U2.4 (PGND), U2.11 (PAD), U2.12 (PAD), U2.13 (PAD), U2.14 (PAD), U2.15 (PAD), X1.GND
GND1: R4.1, R6.1, U2.9 (GND)
unnamed: C4.1, U2.1 (VAUX)
unnamed: L1.P$1 (1), U2.3 (L)
unnamed: D4.C, R9.2
unnamed: R5.1, U1.5 (PROG)
unnamed: R9.1, U1.1 (STAT)
PS: JP13.1, R8.2, U2.8 (PS)
UVLO: C2.2, R3.1, R4.2, SJ2.1, U2.7 (UVLO)
VBATT: C1.1, C2.1, C10.1, JP1.2, JP12.1, L1.P$2 (2), R2.1, R3.2, R8.1, SJ2.2, U1.3 (VBAT), U2.5 (VIN)
VCC: C3.1, JP2.1, R1.2, R7.2, U2.2 (VOUT)

Notes on the sheet:
UVLO 2.6V
Changes to v13 (date:4/3/12)
-added breakout pins for PS and EN
-Route traces on IC directly away from pads to prevent uneven reflow
-move vias under IC so they're not as close to side ground pads
*close jumper SJ2 to disable UVLO*
-added jumper to disable UVLO
A.Weiss
Special Thanks to Oleg at Circuits at Home for the TPS61200 design
LiPo Charger
Switching Regulator
Revision Notes
*VCC can be 3.3V or 5V depending on jumper
*5V is the default

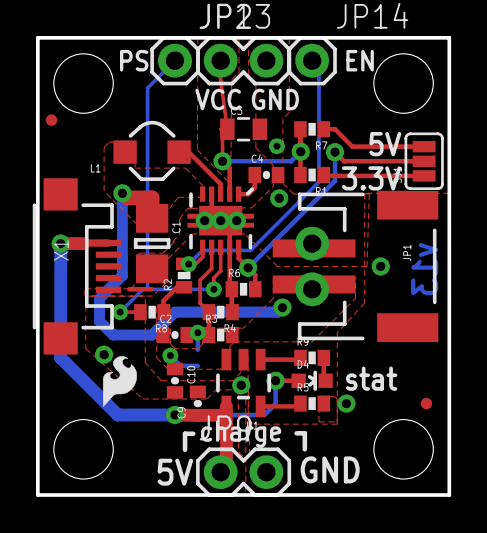
[picture p44: board PowerCell-v13.brd from above]

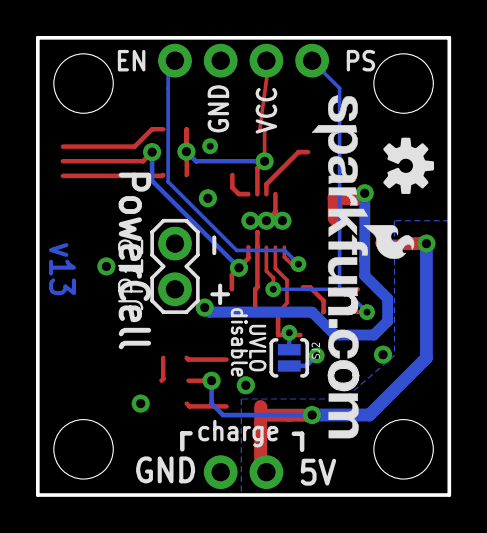
[picture p45: board PowerCell-v13.brd from below]

Board: 2 copper layers, 22.9 x 25.4 mm, 38 parts (4 on the bottom side), 16 nets.
