ssalin/Practicum/hardware/schematics/PowerCell-vArsalan.sch

## EAGLE design hardware/schematics/PowerCell-vArsalan.sch (2016-10-26)

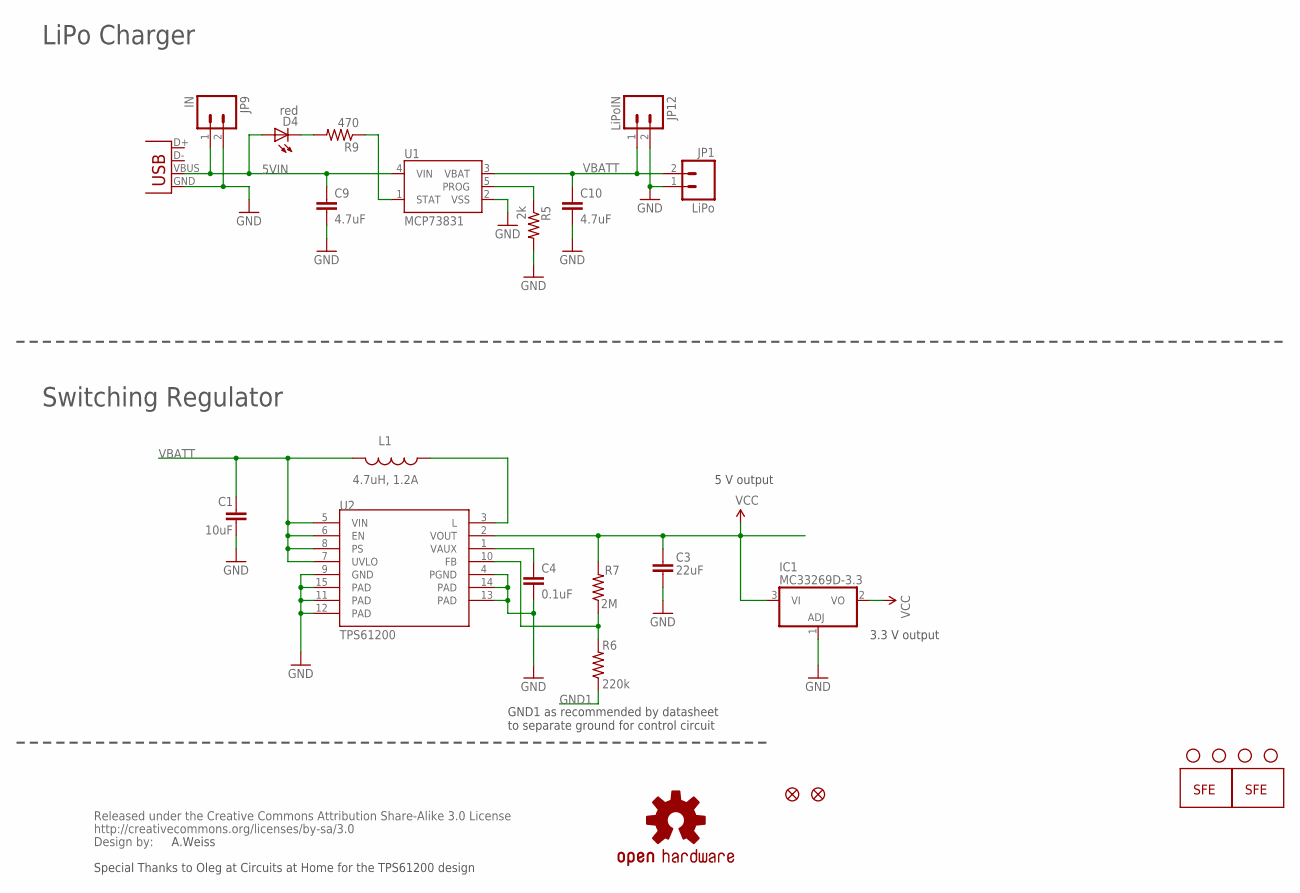
[picture p46: schematic PowerCell-vArsalan.sch]

Parts:
C1: 10uF; 1206
C3: 22uF; 0805
C4: 0.1uF; 0402-CAP
C9, C10: 4.7uF; 0402-CAP
D4: red; LED-0603
IC1: MC33269D-3.3; DPACK
JP1: LiPo; JST-2-SMD
JP3: LOGO-SFENEW; SFE-NEW-WEBLOGO
JP4: LOGO-SFESK; SFE-LOGO-FLAME
JP5, JP6, JP7, JP8: STAND-OFF
JP9: IN; 1X02
JP12: LiPoIN; 1X02
JP15, JP16: FIDUCIALUFIDUCIAL; MICRO-FIDUCIAL
L1: 4.7uH, 1.2A; CDRH2D09
R5: 2k; 0402-RES
R6: 220k; 0402-RES
R7: 2M; 0402-RES
R9: 470; 0402-RES
U1: MCP73831; SOT23-5
U2: TPS61200; QFN-10_PAD
U$1: OSHW-LOGOS; OSHW-LOGO-S
U$2: CREATIVE_COMMONS
X1: USB-MICROB

Connections:
5VIN: C9.1, D4.A, JP9.1, U1.4 (VIN), X1.VBUS
FB: R6.2, R7.1, U2.10 (FB)
GND: C1.2, C3.2, C4.2, C9.2, C10.2, IC1.1 (ADJ), JP1.1, JP9.2, JP12.2, R5.2, U1.2 (VSS), U2.4 (PGND), U2.9 (GND), U2.11 (PAD), U2.12 (PAD), U2.13 (PAD), U2.14 (PAD), U2.15 (PAD), X1.GND
GND1: R6.1
unnamed: C4.1, U2.1 (VAUX)
unnamed: L1.P$1 (1), U2.3 (L)
unnamed: D4.C, R9.2
unnamed: R5.1, U1.5 (PROG)
unnamed: R9.1, U1.1 (STAT)
VBATT: C1.1, C10.1, JP1.2, JP12.1, L1.P$2 (2), U1.3 (VBAT), U2.5 (VIN), U2.6 (EN), U2.7 (UVLO), U2.8 (PS)
VCC: C3.1, IC1.2 (VO), IC1.3 (VI), R7.2, U2.2 (VOUT)

Notes on the sheet:
A.Weiss
Special Thanks to Oleg at Circuits at Home for the TPS61200 design
LiPo Charger
Switching Regulator
5 V output
GND1 as recommended by datasheet to separate ground for control circuit
3.3 V output
