ssalin/Practicum/(commit log)

2016-10-18 - Organized Directories + Added all team planning documents
    [Idea Evaluation Matrix.xlsx, Part List.xlsx, Practicum Cost Sheet.xlsx]
2016-10-20 + For Sam :)
    [Part List.xlsx]
2016-10-26 Battery Charger/Booster Schematic
    [PowerCell-vArsalan.sch]
2016-10-27 Changes 0.2
    Adjust input voltage with sqaure wave
2016-10-27 schematic additions
    added power schematics
    [Schematic.sch]
2016-11-01 schem update
    updated the schematic some
2016-11-01 more updated schematic
    [Schematic.sch]
2016-11-01 better headers
    fixed bluetooth header. still need to change PNP transistors to NMOS.
    [Schematic.sch]
2016-11-02 NMOS, reorganized
    Switched NPN transistors for N-channel MOSFETs, Moved things around to
    make schem more readable
2016-11-03 + Lots of changes and corrections - Does not meet DRC Yet - Still need to implement option to swap out power supplies from 9V battery to LiOn
    [Adafruit BME280.brd, Adafruit BME280.sch, Adafruit EZ-Link Breakout.brd, Adafruit EZ-Link Breakout.sch, Adafruit Latching Relay FeatherWing.brd, Adafruit Latching Relay FeatherWing.sch, Adafruit PowerRelay Wing.brd, Adafruit PowerRelay Wing.sch]
2016-11-03 + Design meets DRC
    [BlueDaq_V1.0.sch]
2016-11-04 Very preliminary start board layout
    [BlueDaq_V1.0.brd]
2016-11-05 updated layout
    preliminary bad layout done
    [BlueDaq_V1.0.sch]
2016-11-05 made grid smaller
    [BlueDaq_V1.0.brd]
2016-11-05 moved some stuff to other side of board
    starting to make big things on top small stuff on bottom for oven
    [BlueDaq_V1.0.sch]
2016-11-07 + Firmware Flowchart
2016-11-07 updated board
    updated layout. starting to have issue connecting gnd properly. added DRU/cam processor for OSH
    [BlueDaq_V1.0.brd, BlueDaq_V1.0.sch]
2016-11-07 no more airwires, only need to clear DRC
    everything is router now, for better or worse
    [BlueDaq_V1.0.brd]
2016-11-07 removed errors
    less DRC errors
    [BlueDaq_V1.0.brd]
2016-11-07 removed DRC errors
    [BlueDaq_V1.0.brd]
2016-11-08 Added in Wire library
2016-11-08 + Pin and Structs added to defs
2016-11-09 removed more DRC errors
    [BlueDaq_V1.0.brd]
2016-11-09 no more DRC errors!
    [BlueDaq_V1.0.brd]
2016-11-11 + Corrected Structs and housekeeping
    [blu_defs.h, bludaq_firmware_V0.1.ino]
2016-11-13 prettier, no DRC errors
    [BlueDaq_V1.0.brd]
2016-11-13 Revert "Struct Constructors"
    This reverts commit d896c1534da5dee60c4173977d94653d818336d6.
    [blu_defs.h, bludaq_firmware_V0.1.ino]
2016-11-13 made vcc line beefier
    [BlueDaq_V1.0.brd]
2016-11-15 + Updated Schematic
    [BlueDaq_V1.0.brd, BlueDaq_V1.0.sch]
2016-11-15 New layout
    [BlueDaq_V1.0.brd, BlueDaq_V1.0.sch]
2016-11-16 + Updated (other) schematic
2016-11-16 minor layout change
    [BlueDaq_V1.0.brd]
2016-11-16 fixed relay, made board smaller
    [BlueDaq_V1.0.brd]
2016-11-16 more small fixes
    [BlueDaq_V1.0.brd]
2016-11-16 Board update
    [BlueDaq_V1.0.brd]
2016-11-16 trace size fixes
    [BlueDaq_V1.0.brd]
2016-11-16 Some fat traces added
    Making it girthy
    [BlueDaq_V1.0.brd]
2016-11-16 More fat traces
    [BlueDaq_V1.0.brd]
2016-11-16 + Minor Changes to Schematic
    [BlueDaq_V1.0.brd]
2016-11-16 added new diode
    [BlueDaq_V1.0.brd]
2016-11-16 more compression
    whole board smaller
    [BlueDaq_V1.0.brd]
2016-11-16 more small fix
    [BlueDaq_V1.0.brd]
2016-11-16 GIRTH
    Maxed out Vcc girth
    [BlueDaq_V1.0.brd]
2016-11-16 added silk layer
    silkscreen so fine so fresh so clean
    [BlueDaq_V1.0.brd]
2016-11-16 + orginization chages
    [Adafruit BME280.brd, Adafruit BME280.sch, Adafruit EZ-Link Breakout.brd, Adafruit EZ-Link Breakout.sch, Adafruit Latching Relay FeatherWing.brd, Adafruit Latching Relay FeatherWing.sch, Adafruit PowerRelay Wing.brd, Adafruit PowerRelay Wing.sch]
2016-11-16 andrew updates
    [BlueDaq_V1.0.brd]
2016-11-16 cleaned up traces a little
    [BlueDaq_V1.0.brd, BlueDaq_V1.0.sch]
2016-11-16 lots of changes
    [BlueDaq_V1.0.brd, BlueDaq_V1.0.sch]
2016-11-16 placed new things, still need to do more routing
    [BlueDaq_V1.0.brd]
2016-11-17 more routed
    [BlueDaq_V1.0.brd]
2016-11-17 All traces are routed
    [BlueDaq_V1.0.brd]
2016-11-17 fixed silk
    [BlueDaq_V1.0.brd]
2016-11-17 removed DRC
    [BlueDaq_V1.0.brd]
2016-11-17 fixed gnd poly
    [BlueDaq_V1.0.brd]
2016-11-17 Minor fixes
    [BlueDaq_V1.0.brd]
2016-11-17 naming
    special for andy
    [BlueDaq_V1.0.brd]
2016-11-17 Corrected posts to bottom layer
    [BlueDaq_V1.0.brd]
2016-11-17 oh no fix
    [BlueDaq_V1.0.brd, BlueDaq_V1.0.sch]
2016-11-17 fixed comps being too dang small
    [BlueDaq_V1.0.brd, BlueDaq_V1.0.sch]
2016-11-17 + small silk update
    [BlueDaq_V1.0.brd]
2016-11-20 cleaned up /schem/docs, some parts list work
    [Part List.xlsx, Parts_list.xlsx]
2016-11-20 + BT Firmware Tests + iOS App: + Serial Connections work + Device can be selected / TX & RX + BlueDaq Communications defined (parser created) + Passcode function in debugging phase
2016-11-20 updated schematic
    [Parts_list.xlsx]
2016-11-20 + Restored parts list
    [Parts_list.xlsx]
2016-11-21 + Authentication between app and system now works + Serial Com Classes for Device and iOS improved
2016-11-21 better part list
    [Parts_list.xlsx]
2016-11-21 better-er parts list
    still need to add prices for everything
    [Parts_list.xlsx]
2016-11-21 Added prices
    [Parts_list.xlsx]
2016-11-22 Added more pricing
    [Parts_list.xlsx]
2016-11-22 updated cost math a bit
    [Parts_list.xlsx]
2016-11-23 + Fixed Persistence Issue between views (segue data methods with storage class) + GUI for sensors and automation added
2016-11-24 Revert "RX functions"
    This reverts commit 5e96978ff3bc8db5ebb591c321004092b8fbfd2d.
    [blu_defs.h]
2016-11-28 solder stencil output
    hopefully it works
2016-11-29 + Sensor RX Functions Completed
2016-12-02 + Minor Changes to Sensor View
2016-12-04 + Added toggle to Firmware RX + App sensor data working with parsing errors.
    [blu_defs.h, bludaq_firmware_V0.1.ino]
2016-12-04 EEPROM/Timer Checkpoint
2016-12-05 + Sensor View is working! - Automation is sending - but not recognized… + Manual automation settings are working (in debug mode)
2016-12-05 EEPROM and Toggle Timer
2016-12-08 + Fixed some of the automation problems + Added several missing RX functions + Fixed bad RX functions
    [blu_defs.h, bludaq_firmware_V0.1.ino]
2016-12-08 Bill of materials pdf and excel
    [Bill of Materials.xlsx]
